bob70/IC-Tester/README.md

# IC-Tester
PCC Capstone project. Tests the functionality of IC logic chips.
