bob70/IC-Tester/Logs/hardware log.rtf

First - 8 pins on micro controller to eight AND inputs. LEDs on each input and output for visualization. four micro controller pins required for AND outputs.

second - two micro controller outputs to 4 AND inputs each

third - two up counters to cycle through full range of input combinations. only one micro controller output required. Counters are hand controlled. ZIF socket now available.

4/20/15
Added safety diodes and a decoupling capacitor to power lines.

4/26/15
Micro controller now controlling counters instead of hand.
Added more LEDs to indicate all logic types (AND, OR, NAND, NOR, XOR)
