bob70/IC-Tester/Logs/price list.rtf

NOR - $2.50
Zif socket - $8
breadboard - $19
Multimeter - $25
