bob70/IC-Tester/Proposal/ProjectProposal.pdf

# My Project Proposal

by
James Solonika

Submitted to the Electronics Engineering Tech Program at Portland Community College 2015-04-09

Abstract:
My proposed project is to create a tester and identifier for common ICs that are used in school labs. This would both identify unknown chips and verify correct function. This would be of use in lab as well as potentially in industry to verify that components being used are working correctly.

Introduction:
Sometimes in school or professional situations we may be required to make large logic circuits. Occasionally, the chips we use may not be outputting the correct logic. This project aims to create a small, affordable test item to verify the logic function of IC logic chips.

This project will be created with multiple goals in mind, reaching as many as are possible in the allowed time. These goals are as follows:
1) Be able to verify the logic function of ICs
2) Be able to identify unknown logic chips
3) Verify the operational characteristics of other ICs, such as op-amps and flip flops
4) Evaluate other components such as resistors and capacitors.
These goals will be worked in order as long as time allows. A side goal will be to create a case for the whole project. This will be created as time allows. If I decide that it makes more sense to continue with functionality, I may not have time to create a mounted environment.

The ultimate goal is to create a small, affordable test kit that can be used in labs to verify the operation of components. Currently, the only way to verify this functionality of ICs that I have seen in school labs is to apply logic states by hand and use a DMM to record the results. This project will reduce the time to verify the function of components and allow a student or professional to correct the problem or move on to checking their wiring faster.

Preliminary Research:
Currently, IC testers are available that can test many kind of general faults in any IC chip. These cost upwards of $1,000 however. My goal is to create a cheaper alternative that can be used in school labs for common specific component testing. By targeting specific chips, such as logic and amplifiers, we reduce the overall functionality but also reduce cost and complexity.

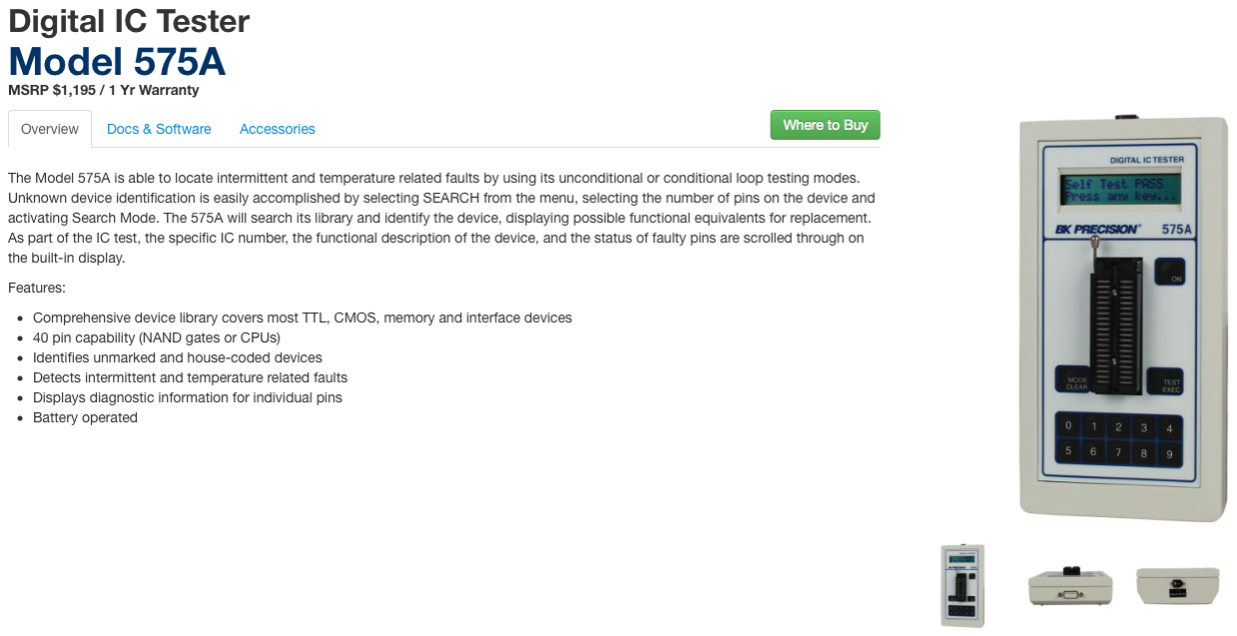
[picture p10: figure]

The above is a current model of IC tester. Note the price of $1,195. I aim to create a device with a parts cost of around $75. This would be far more available for labs.

Other research: Conversations with fellow students has indicated that this would be a well received addition to lab studies.

Future Research:
1) How do I measure and create a case for the project. Currently, I do not know the size of the project or have any knowledge of CAD programs, but do have access to 3D printing and laser cutting equipment.
2) How to measure analog components. I understand already how to test digital functions using a microcontroller, but not how to measure resistance or capacitance.
3) Will I be able to identify unknown ICs? I think I can run test signals over each pin on the IC, but don't want to burn out the chip by applying an inappropriate voltage to a pin.

Generally, my approach is to work towards completing the project goals as outlined above, and learn how to create even more functionality that I have considered. Since I plan to base the logic in an Arduino microcontrolloer, this will mostly involve research on Arduino’s website, which contains great programming resources. Lastly, I plan to ask others what additional features others may want that I have not yet considered.

Concept Work:

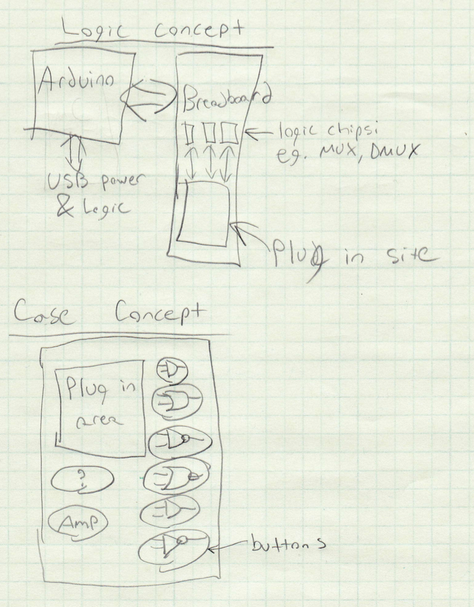
[picture p11: figure]
