bob70/IC-Tester/Reference Files/7400.GIF.jpeg

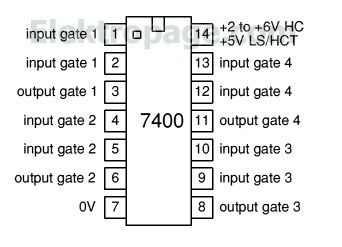
Reference Files/7400.GIF.jpeg
