bob70/IC-Tester/Reference Files/logicchips-252x300.jpg

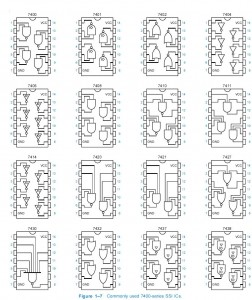
Reference Files/logicchips-252x300.jpg
