bob70/IC-Tester/Reference Files/Screen Shot 2015-04-20 at 2.48.09 PM.png

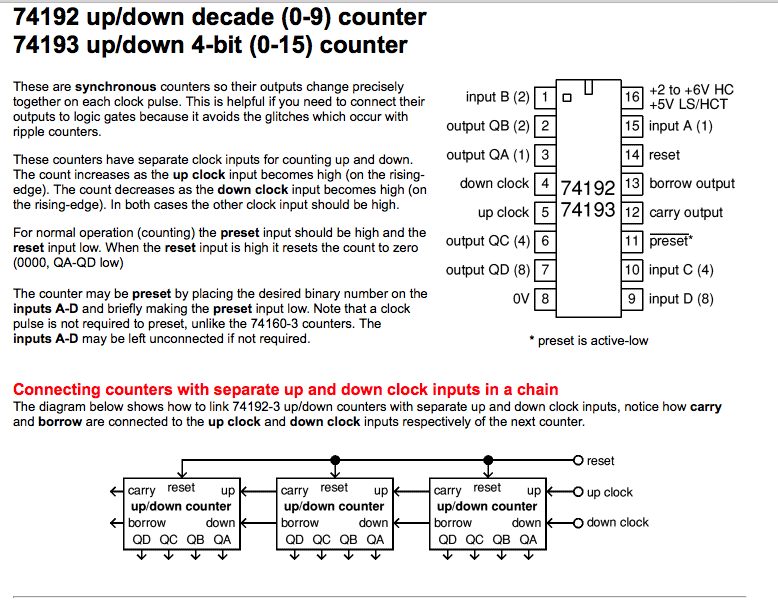
Reference Files/Screen Shot 2015-04-20 at 2.48.09 PM.png
