bob70/IC-Tester/Tool Scripts/for_capstone.stl

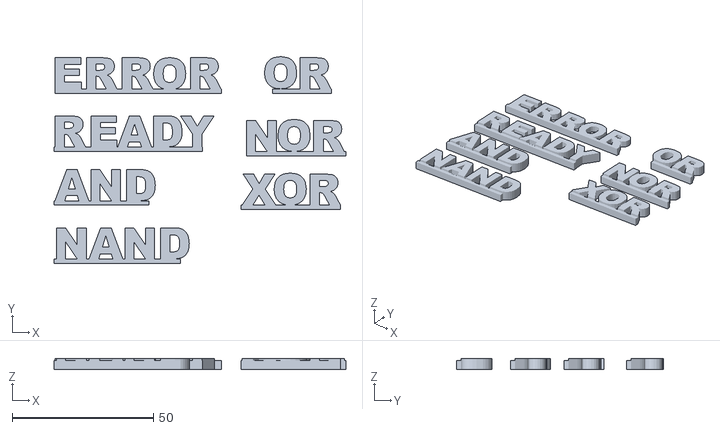
[picture p21: CAD file, 2018-07-22]
Tool Scripts/for_capstone.stl
103.5 x 73.4 x 4.00
